Daniel-Clint/smart-door-locker/doc/pcb3d图.png

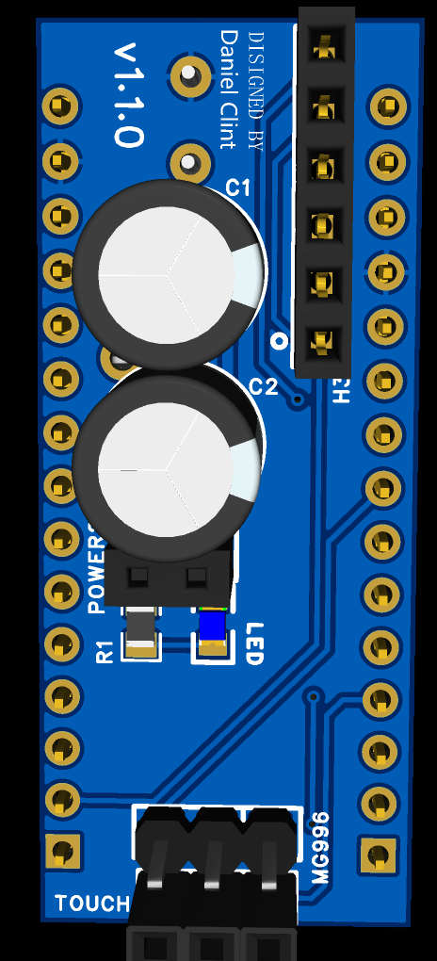
doc/pcb3d图.png
