Daniel-Clint/smart-door-locker/doc/pcb.png

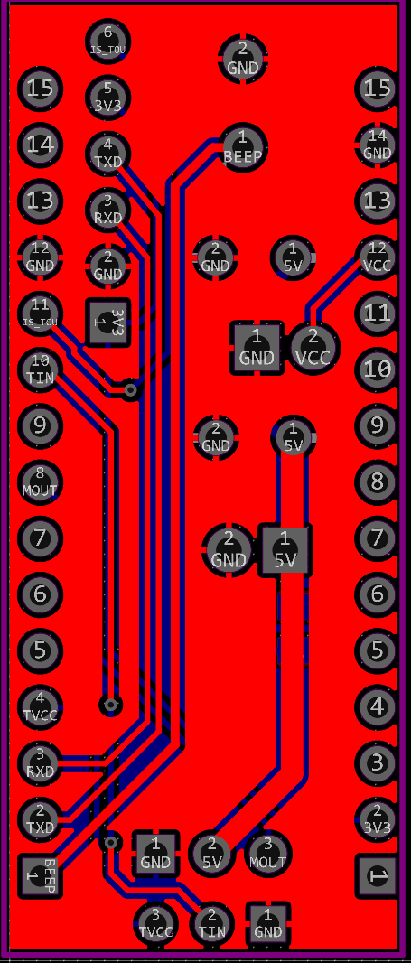
doc/pcb.png
