Daniel-Clint/smart-door-locker/hardware/arduino_nano_size.pdf

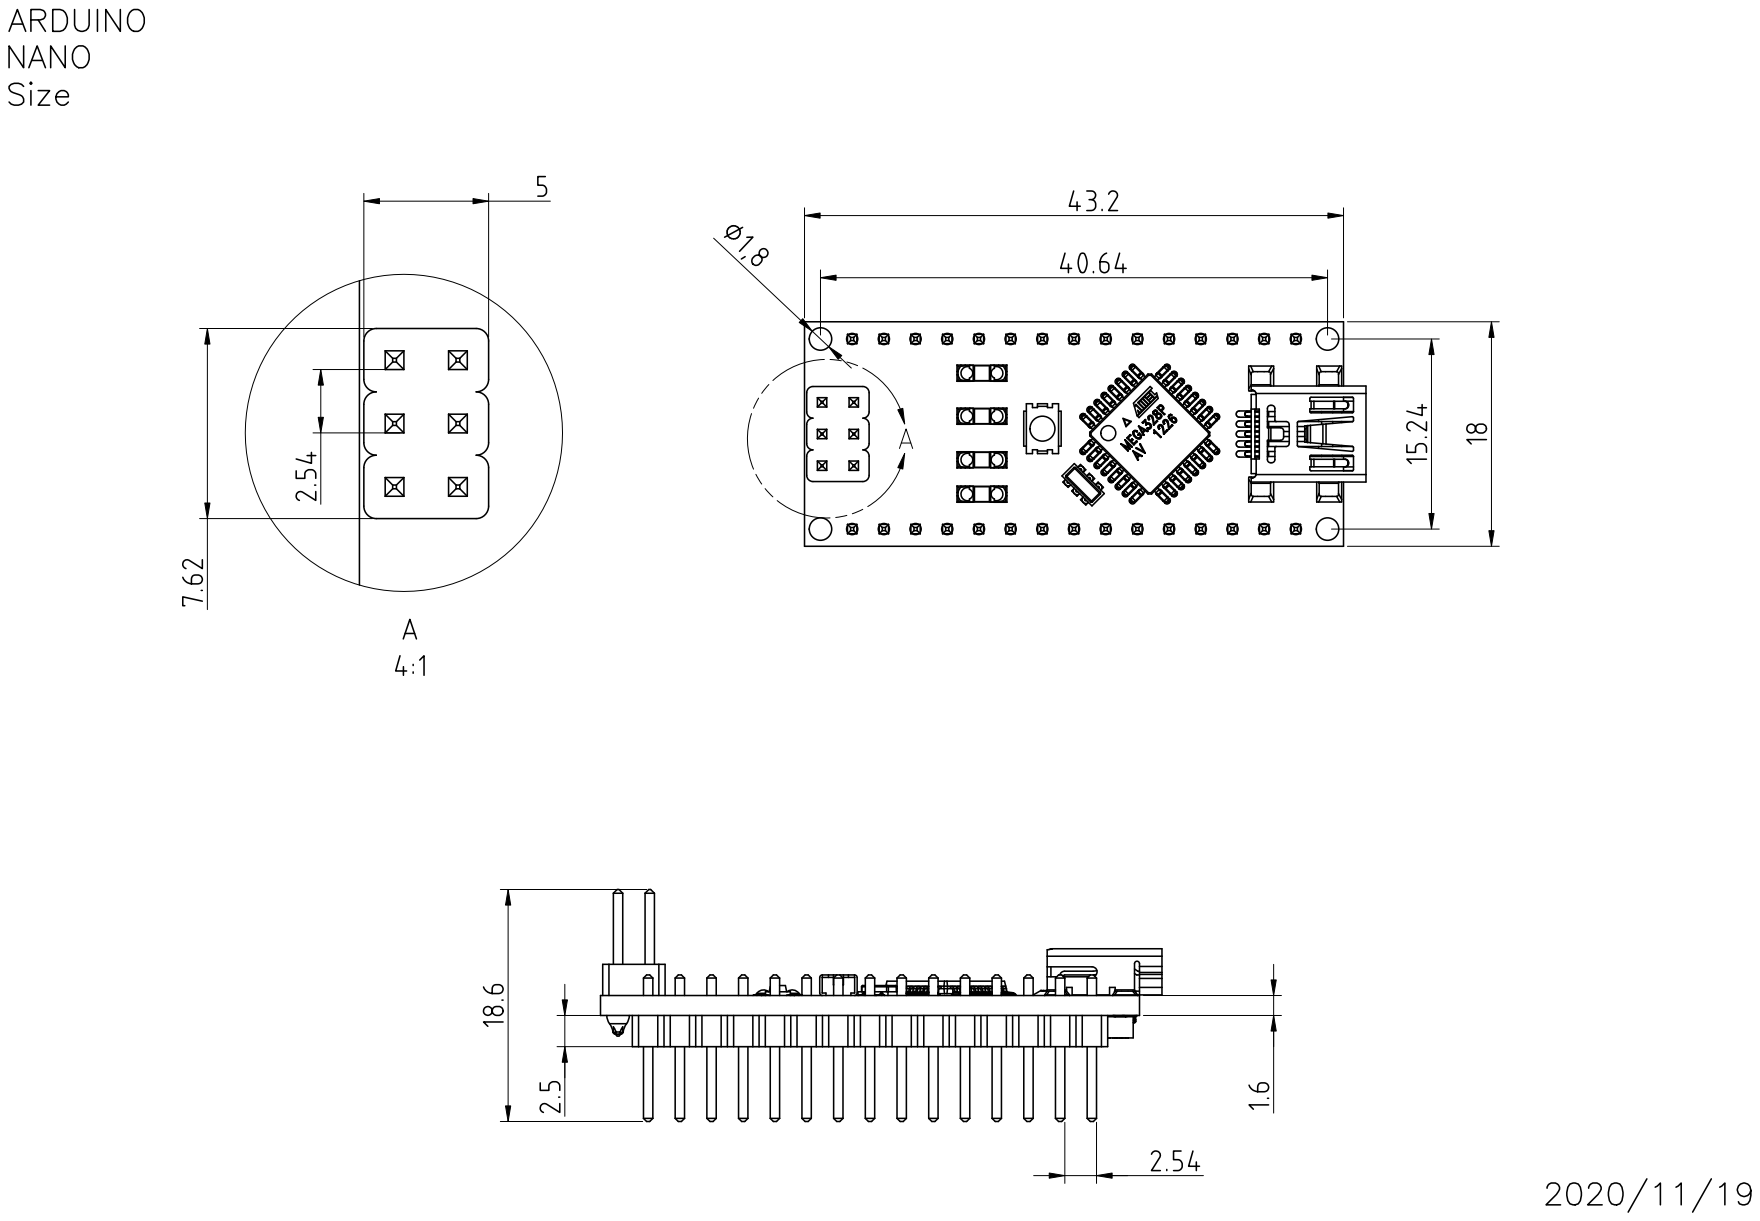
[picture p12: page 1]
